thomassadowsky/Wordclock-Japan/docs/images/wordclock_jp_off.png

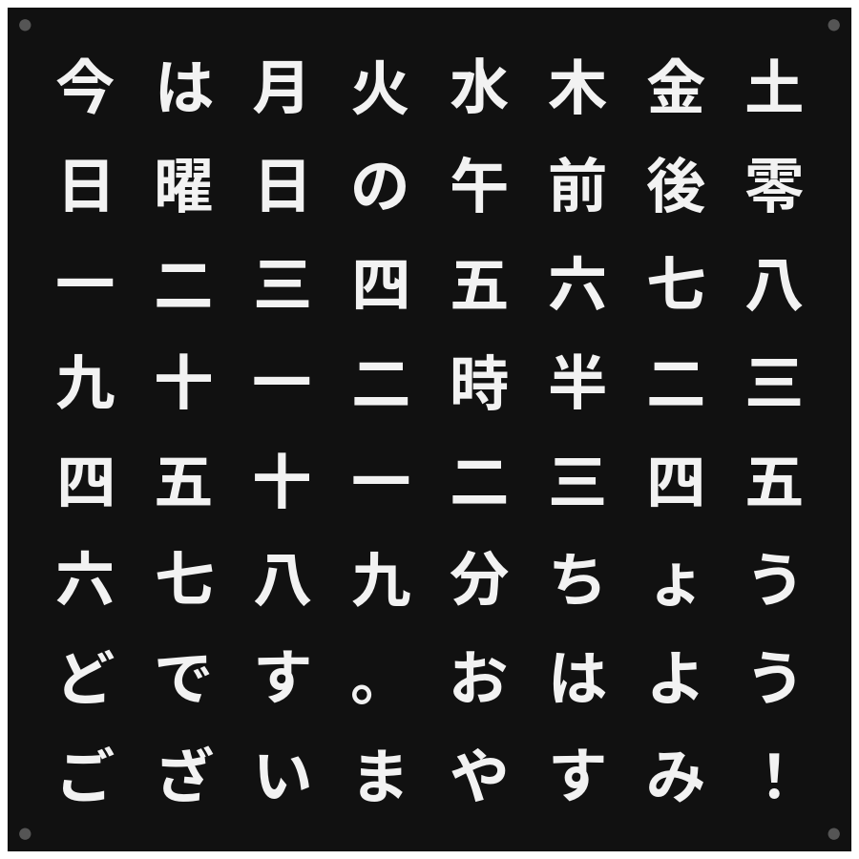
docs/images/wordclock_jp_off.png
