thomassadowsky/Wordclock-Japan/docs/images/wordclock_jp_rueckseite.png

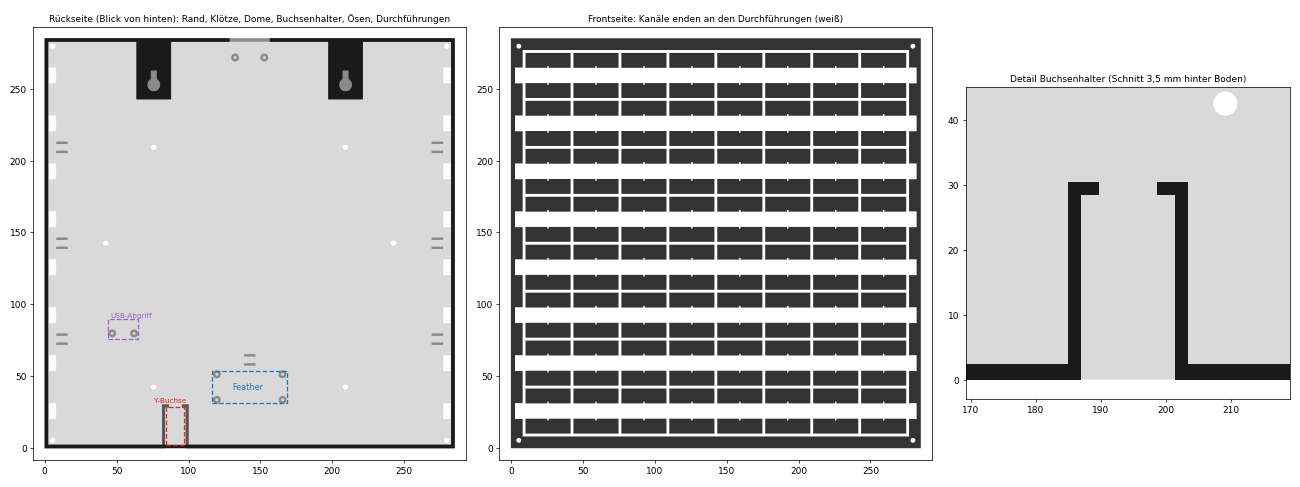
docs/images/wordclock_jp_rueckseite.png
