thomassadowsky/Wordclock-Japan/docs/images/wordclock_jp_staender.png

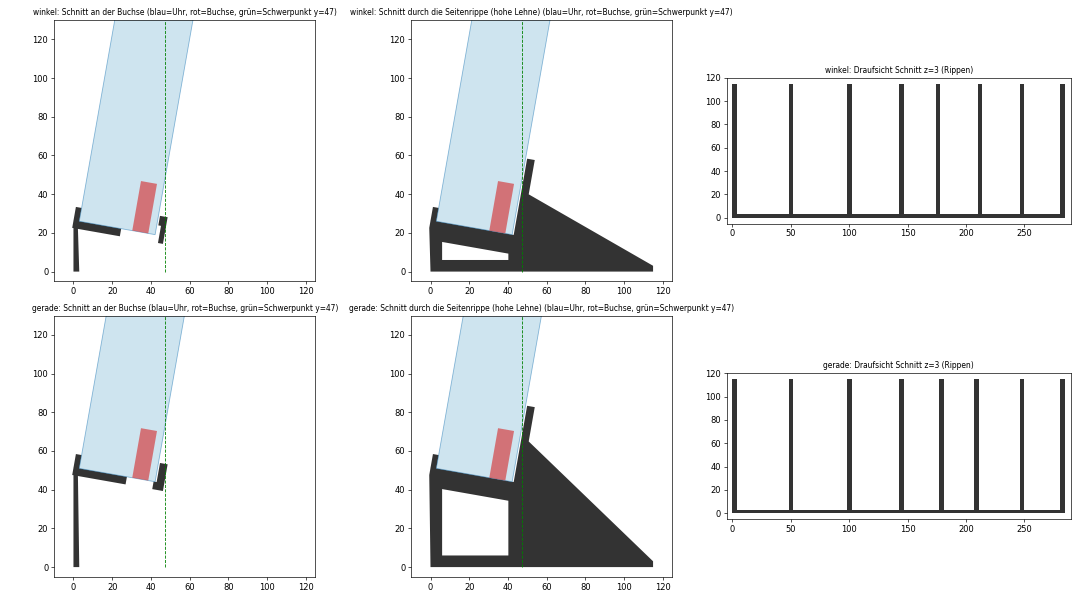
docs/images/wordclock_jp_staender.png
