thomassadowsky/Wordclock-Japan/pictures/adafruit-feather-esp32.jpeg

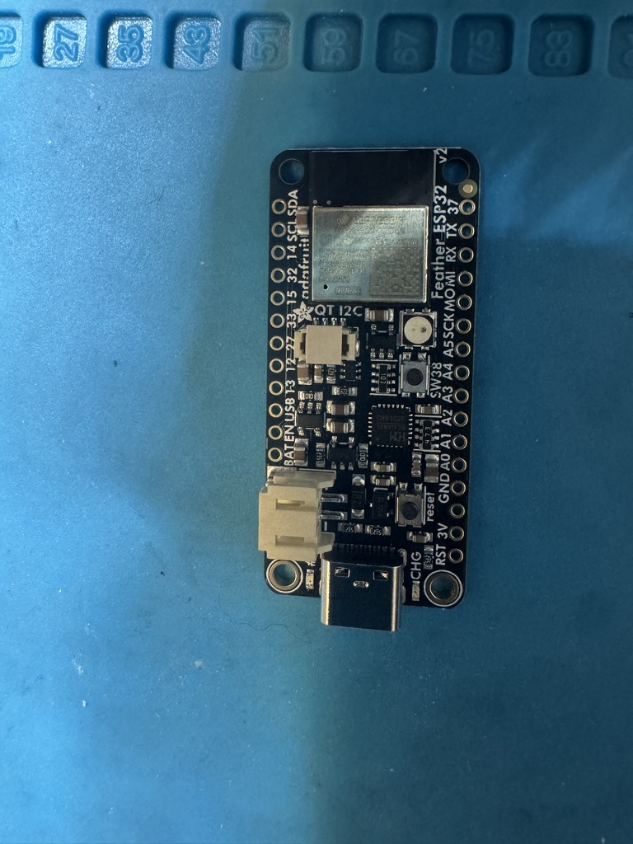
pictures/adafruit-feather-esp32.jpeg
