thomassadowsky/Wordclock-Japan/pictures/usb-c-power-adapter.jpeg

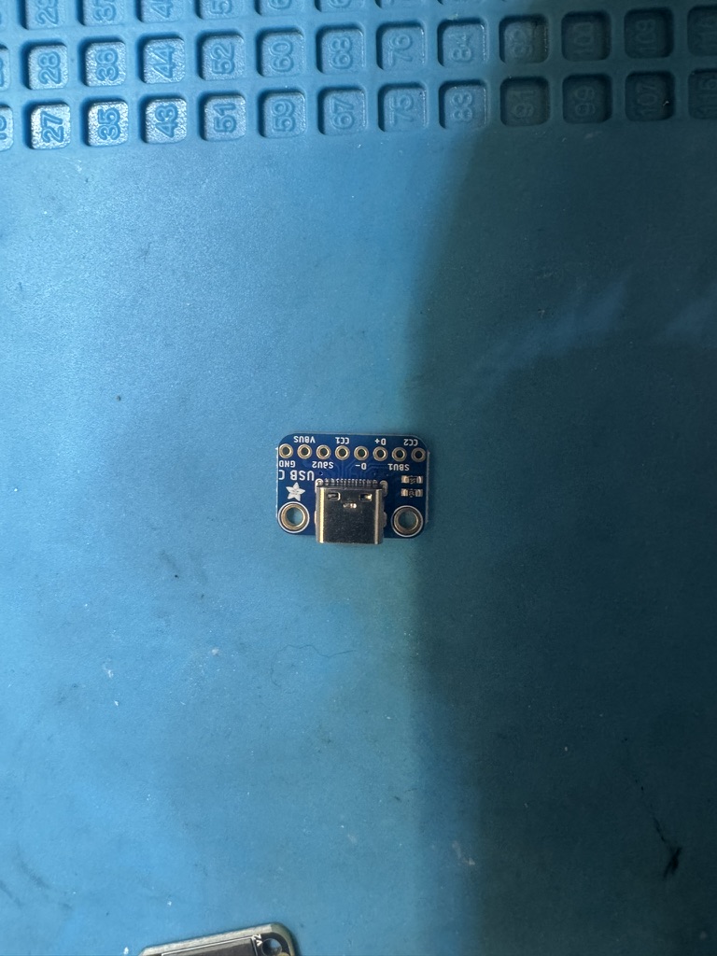
pictures/usb-c-power-adapter.jpeg
