thomassadowsky/Wordclock-Japan/pictures/usb-c-y-cable.jpeg

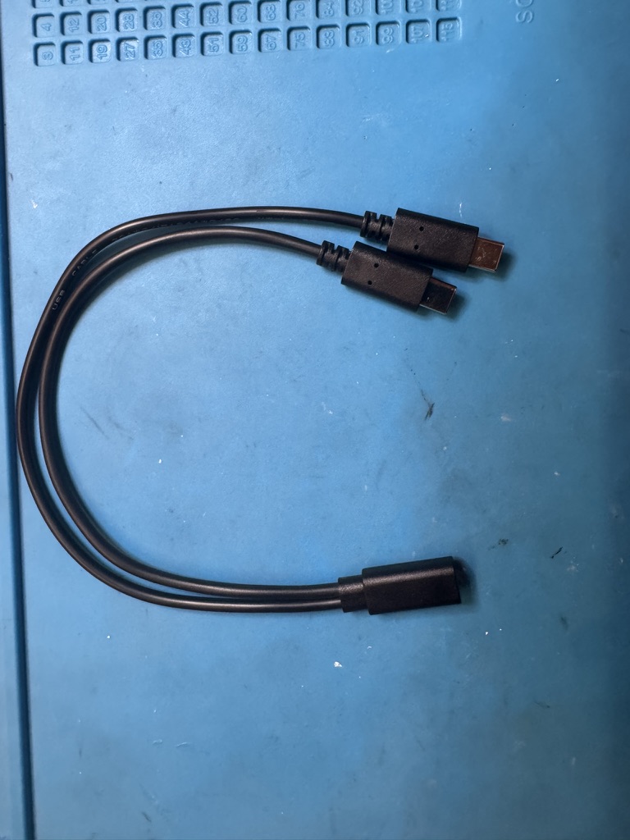
pictures/usb-c-y-cable.jpeg
