thomassadowsky/Wordclock-Japan/3d-print-files/3mf/wordclock_jp_raster.3mf

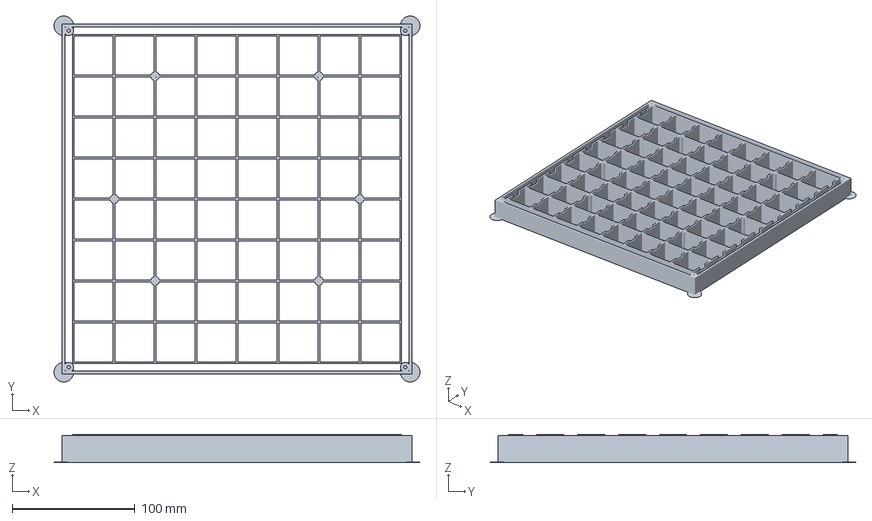
[picture p19: CAD file, 2026-10-15]
3d-print-files/3mf/wordclock_jp_raster.3mf
298.0 x 298.0 x 23.0 mm
