thomassadowsky/Wordclock-Japan/3d-print-files/test/boden_test.3mf

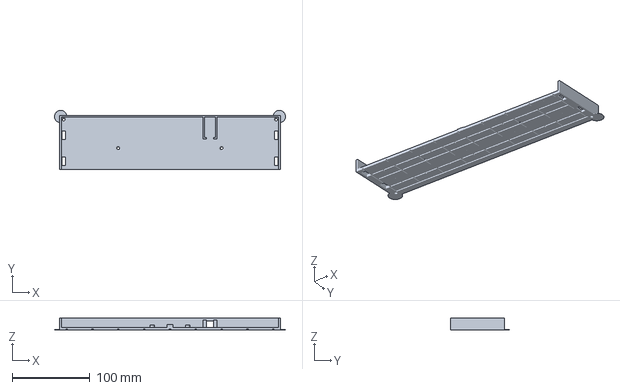
[picture p20: CAD file, 2026-10-15]
3d-print-files/test/boden_test.3mf
298.0 x 76.5 x 15.0 mm
