thomassadowsky/Wordclock-Japan/3d-print-files/3mf/wordclock_jp_luxadapter_4mm.3mf

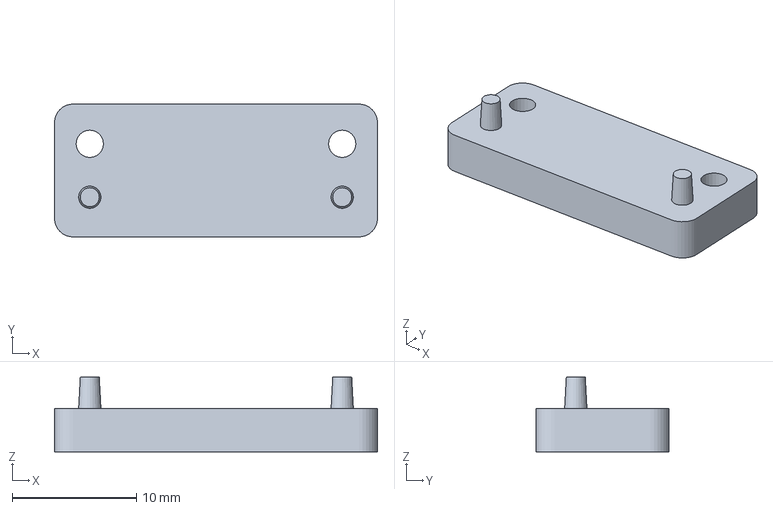
[picture p21: CAD file, 2026-10-15]
3d-print-files/3mf/wordclock_jp_luxadapter_4mm.3mf
26.0 x 10.7 x 6.00 mm
