thomassadowsky/Wordclock-Japan/3d-print-files/test/wordclock_jp_test_diffusor.3mf

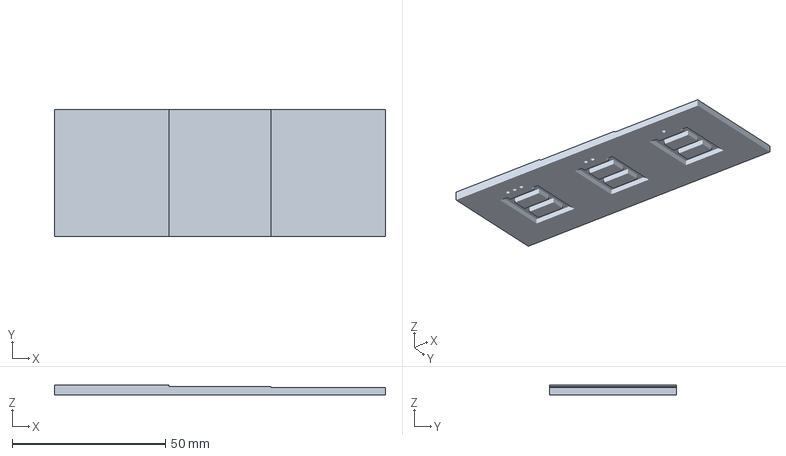
[picture p22: CAD file, 2026-10-15]
3d-print-files/test/wordclock_jp_test_diffusor.3mf
108.0 x 41.3 x 3.20 mm
