thomassadowsky/Wordclock-Japan/3d-print-files/3mf/wordclock_jp_front.3mf

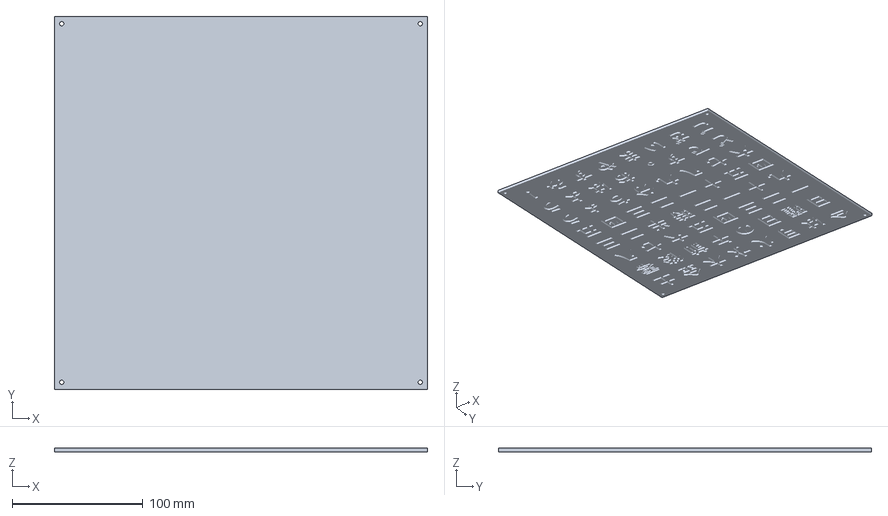
[picture p23: CAD file, 2026-10-15]
3d-print-files/3mf/wordclock_jp_front.3mf
285.0 x 285.0 x 2.80 mm
