thomassadowsky/Wordclock-Japan/3d-print-files/test/wordclock_jp_test_front.3mf

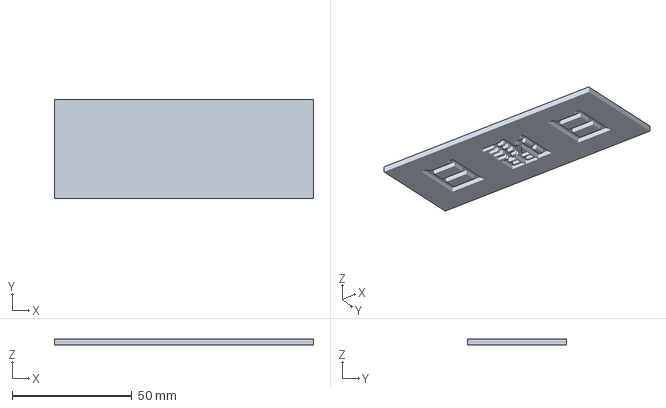
[picture p24: CAD file, 2026-10-15]
3d-print-files/test/wordclock_jp_test_front.3mf
108.0 x 41.3 x 2.40 mm
