thomassadowsky/Wordclock-Japan/3d-print-files/3mf/wordclock_jp_staender_gerade.3mf

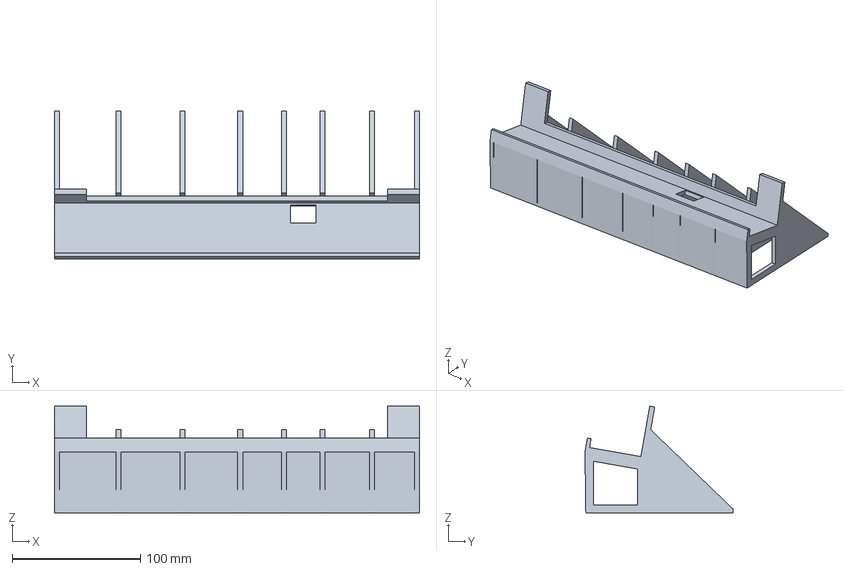
[picture p25: CAD file, 2026-10-15]
3d-print-files/3mf/wordclock_jp_staender_gerade.3mf
285.0 x 115.6 x 83.3 mm
