thomassadowsky/Wordclock-Japan/3d-print-files/3mf/wordclock_jp_staender_winkel.3mf

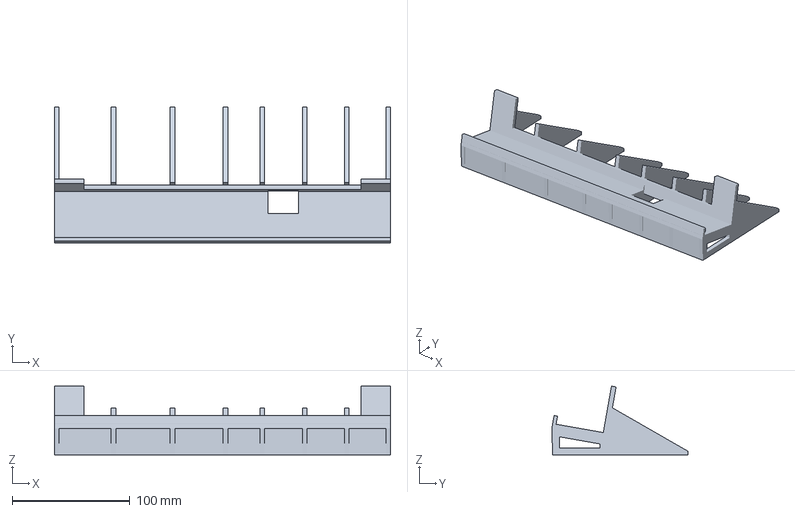
[picture p26: CAD file, 2026-10-15]
3d-print-files/3mf/wordclock_jp_staender_winkel.3mf
285.0 x 115.6 x 58.3 mm
