thomassadowsky/Wordclock-Japan/3d-print-files/3mf/wordclock_jp_boden.3mf

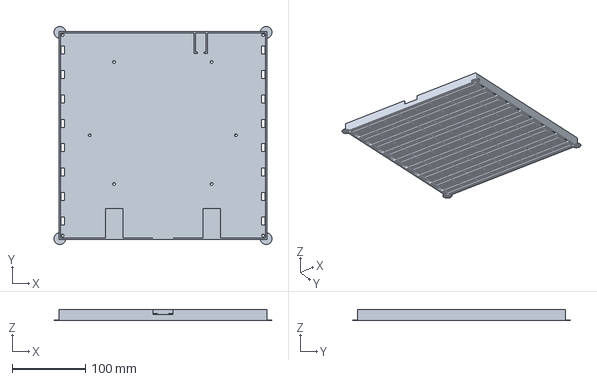
[picture p27: CAD file, 2026-10-15]
3d-print-files/3mf/wordclock_jp_boden.3mf
298.0 x 298.0 x 15.0 mm
