thomassadowsky/Wordclock-Japan/(list of files, cad)

Other CAD files:
3d-print-files/stl/wordclock_jp_boden.stl
3d-print-files/stl/wordclock_jp_front.stl
3d-print-files/stl/wordclock_jp_luxadapter_2mm.stl
3d-print-files/stl/wordclock_jp_luxadapter_4mm.stl
3d-print-files/stl/wordclock_jp_raster.stl
3d-print-files/stl/wordclock_jp_staender_gerade.stl
3d-print-files/stl/wordclock_jp_staender_winkel.stl
3d-print-files/test/wordclock_jp_test_diffusor.stl
3d-print-files/test/wordclock_jp_test_front.stl
