thomassadowsky/Wordclock-Japan/docs/images/wordclock_jp_test_diffusor.png

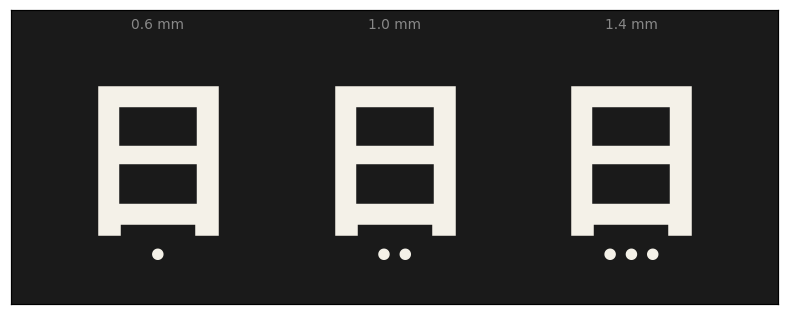
docs/images/wordclock_jp_test_diffusor.png
