thomassadowsky/Wordclock-Japan/docs/images/wordclock_jp_test_front.png

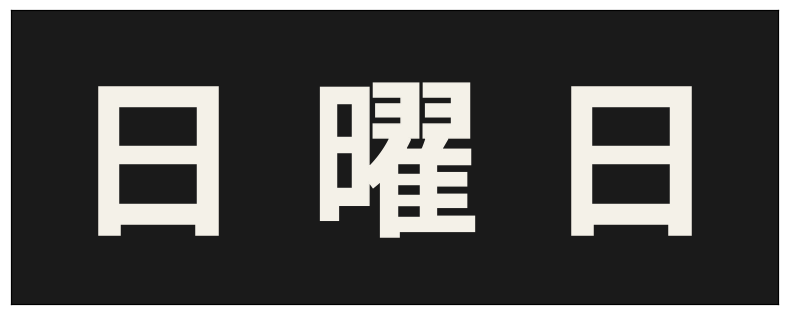
docs/images/wordclock_jp_test_front.png
